paramintrt94/MOST-Vaccine-Exhibit/README.md

# MOST-Vaccine_Exhibit
Exhibit demonstrating how vaccines work
