paramintrt94/MOST-Vaccine-Exhibit/3D Models/Printed Parts (STL Files)/Exhibit Accessories/I2C Assembly Block.stl

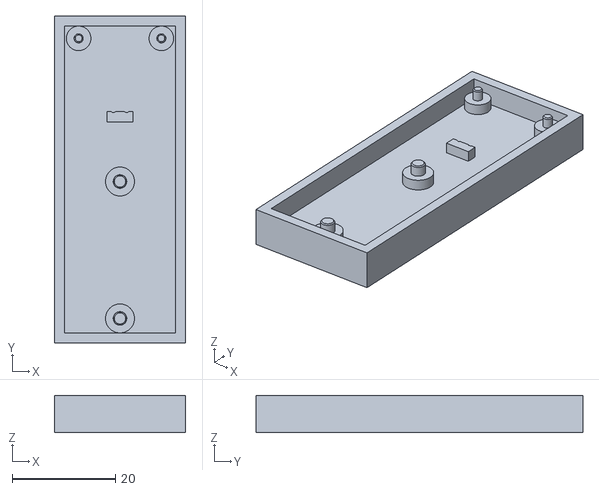
[picture p1: CAD file, 2021-02-23]
3D Models/Printed Parts (STL Files)/Exhibit Accessories/I2C Assembly Block.stl
25.4 x 63.3 x 7.25
