paramintrt94/MOST-Vaccine-Exhibit/3D Models/Printed Parts (STL Files)/Exhibit Accessories/Piece Locator.stl

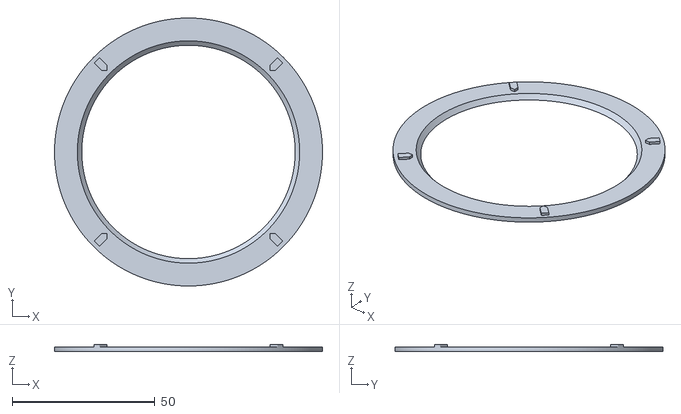
[picture p2: CAD file, 2021-02-23]
3D Models/Printed Parts (STL Files)/Exhibit Accessories/Piece Locator.stl
93.8 x 93.8 x 2.60
