paramintrt94/MOST-Vaccine-Exhibit/3D Models/Printed Parts (STL Files)/Model Pieces/Clear White Blood Cell.stl

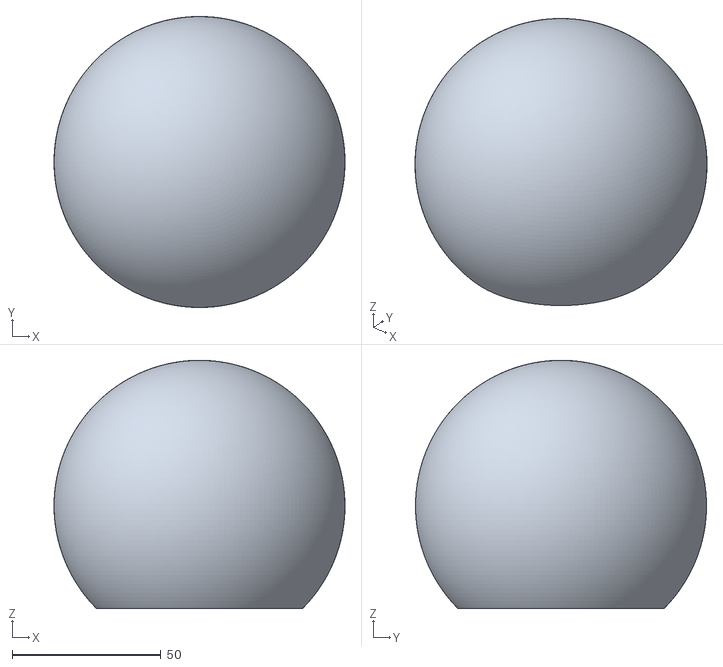
[picture p3: CAD file, 2021-02-23]
3D Models/Printed Parts (STL Files)/Model Pieces/Clear White Blood Cell.stl
98.0 x 98.0 x 83.6
