paramintrt94/MOST-Vaccine-Exhibit/3D Models/CAD Files/tca9548a_multiplexer.stp

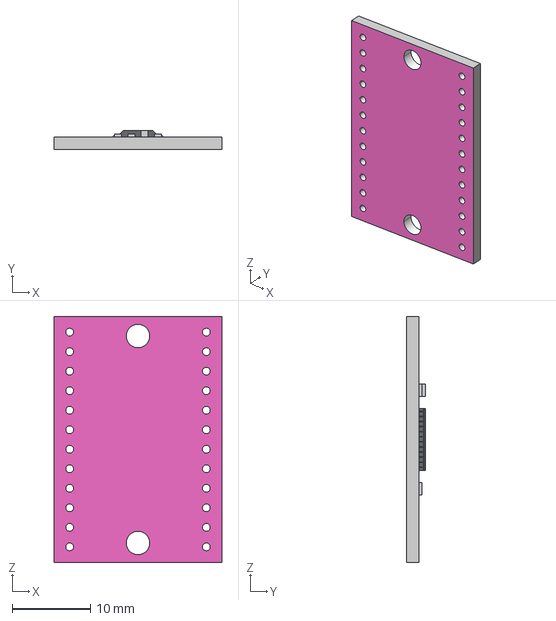
[picture p4: CAD file, 2021-02-23]
3D Models/CAD Files/tca9548a_multiplexer.stp
21.5 x 2.40 x 31.5 mm
