paramintrt94/MOST-Vaccine-Exhibit/3D Models/Printed Parts (STL Files)/Model Pieces/Red Active Virus Base.stl

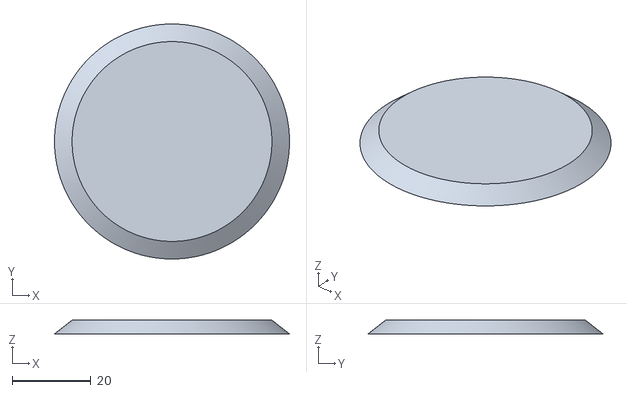
[picture p5: CAD file, 2021-02-23]
3D Models/Printed Parts (STL Files)/Model Pieces/Red Active Virus Base.stl
59.8 x 59.8 x 3.50
