paramintrt94/MOST-Vaccine-Exhibit/3D Models/Printed Parts (STL Files)/Exhibit Accessories/RGB Sensor Holder.stl

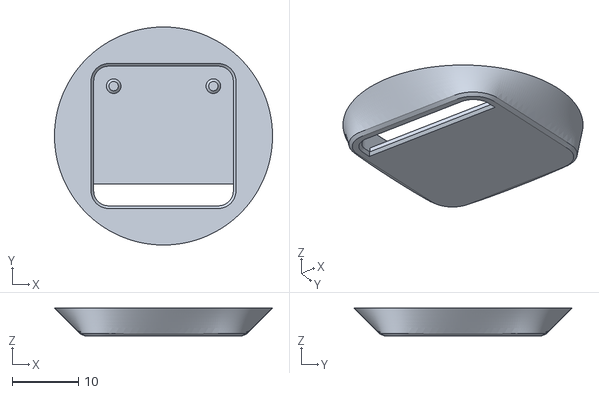
[picture p6: CAD file, 2021-02-23]
3D Models/Printed Parts (STL Files)/Exhibit Accessories/RGB Sensor Holder.stl
32.8 x 32.8 x 4.20
