paramintrt94/MOST-Vaccine-Exhibit/3D Models/Printed Parts (STL Files)/Model Pieces/Green Active Virus.stl

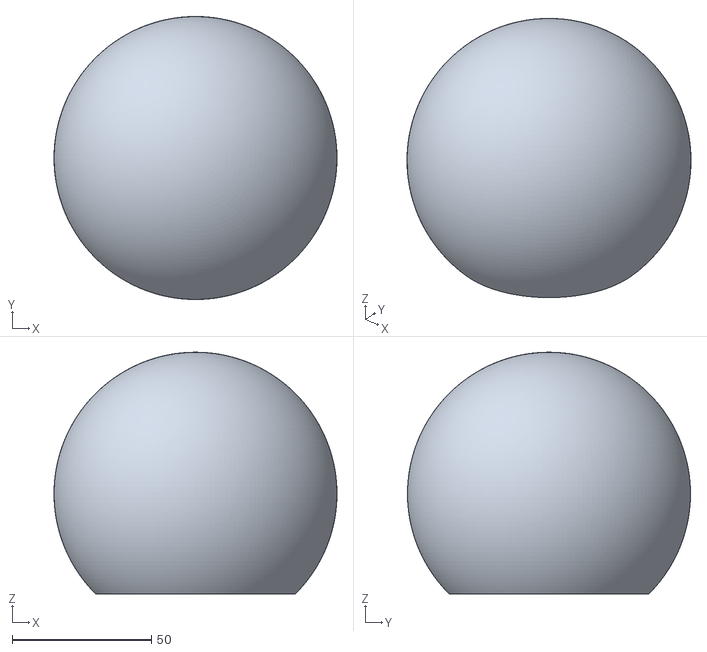
[picture p7: CAD file, 2021-02-11]
3D Models/Printed Parts (STL Files)/Model Pieces/Green Active Virus.stl
101.6 x 101.6 x 86.7
