paramintrt94/MOST-Vaccine-Exhibit/3D Models/Printed Parts (STL Files)/Exhibit Accessories/LED Diode Holder.stl

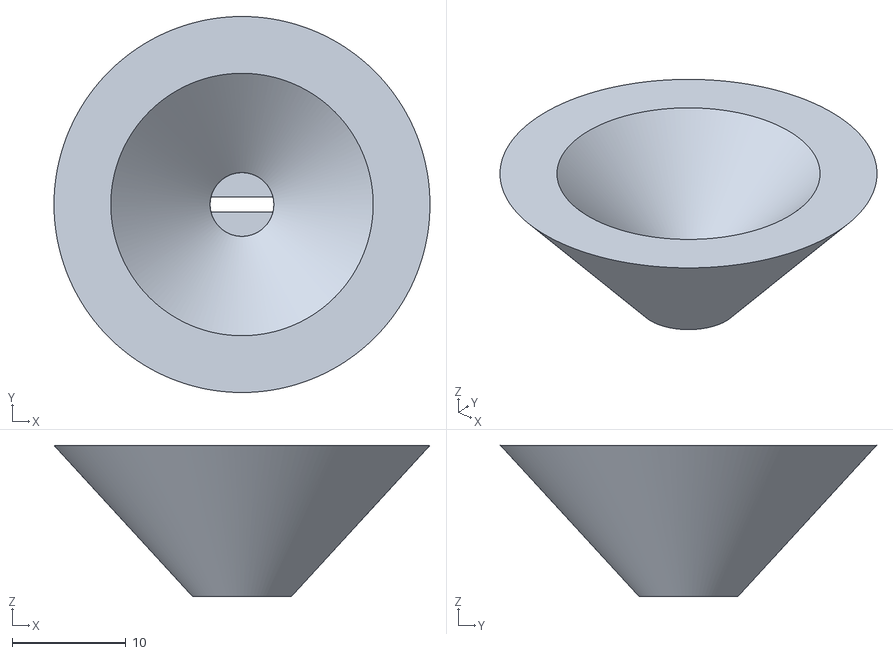
[picture p8: CAD file, 2021-02-23]
3D Models/Printed Parts (STL Files)/Exhibit Accessories/LED Diode Holder.stl
33.1 x 33.1 x 13.3
