paramintrt94/MOST-Vaccine-Exhibit/3D Models/Printed Parts (STL Files)/Exhibit Accessories/RGB Resistor Board Holder.stl

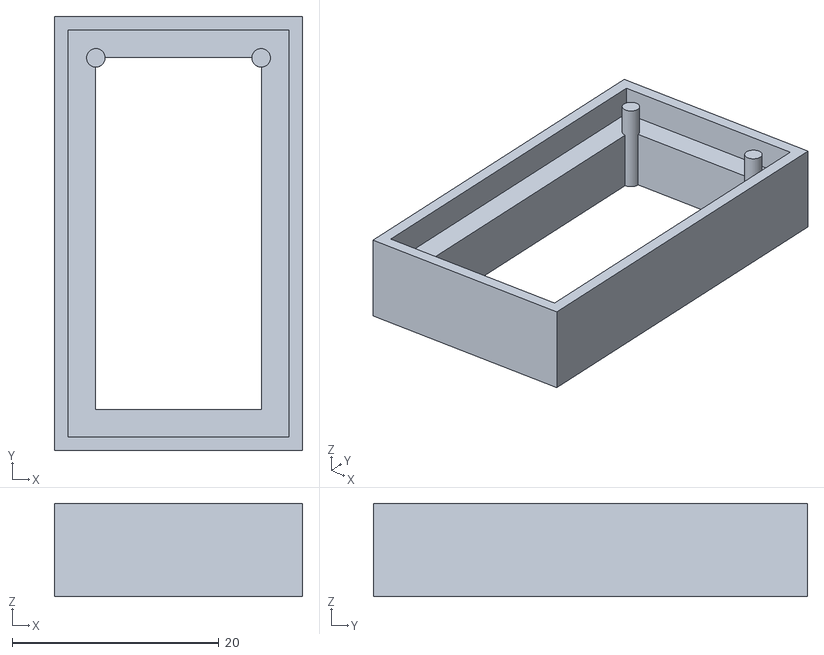
[picture p9: CAD file, 2021-02-23]
3D Models/Printed Parts (STL Files)/Exhibit Accessories/RGB Resistor Board Holder.stl
24.0 x 42.0 x 9.00
