paramintrt94/MOST-Vaccine-Exhibit/3D Models/Printed Parts (STL Files)/Model Pieces/Green Protein Receptor Cone.stl

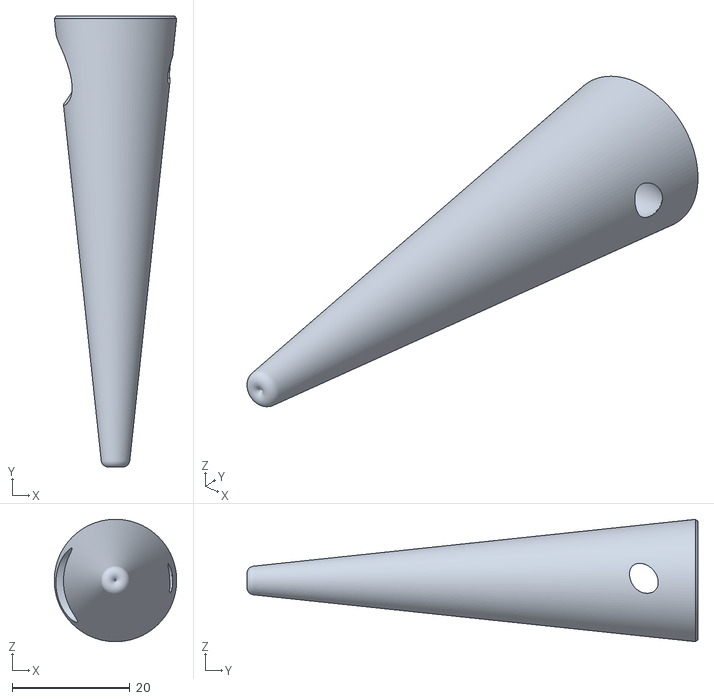
[picture p10: CAD file, 2021-02-10]
3D Models/Printed Parts (STL Files)/Model Pieces/Green Protein Receptor Cone.stl
20.8 x 76.5 x 20.8
