paramintrt94/MOST-Vaccine-Exhibit/3D Models/CAD Files/tcs34725_rgb_sensor.igs

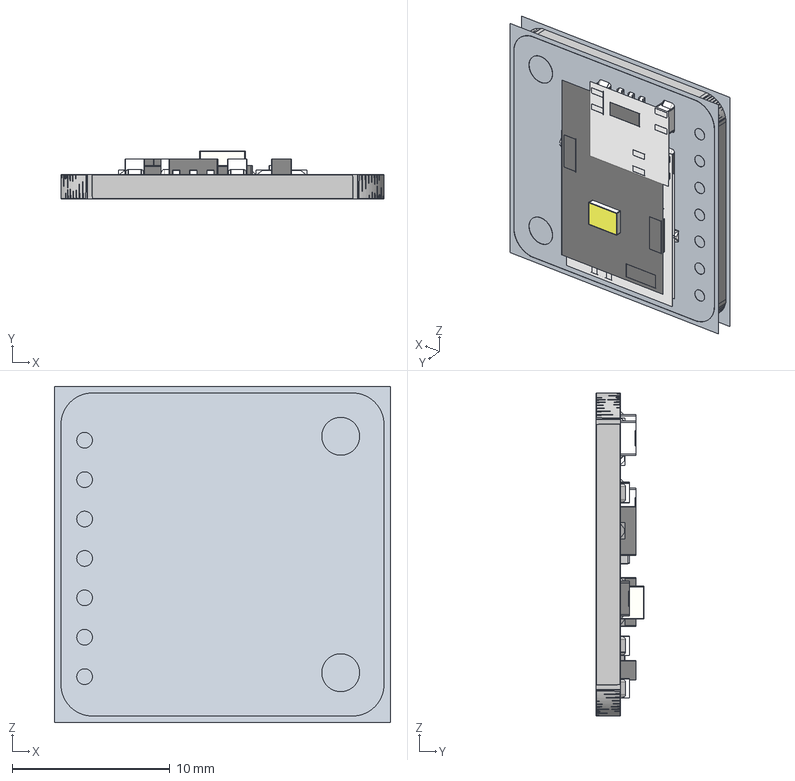
[picture p11: CAD file, 2021-02-23]
3D Models/CAD Files/tcs34725_rgb_sensor.igs
21.3 x 3.06 x 21.3 mm
