paramintrt94/MOST-Vaccine-Exhibit/(list of files, cad)

Other CAD files:
3D Models/Printed Parts (STL Files)/Model Pieces/Green Modified Virus.stl
