paramintrt94/MOST-Vaccine-Exhibit/(list of files, drawings)

Other design files:
Documentation/Vaccine Demo Schematic.fzz
