paramintrt94/MOST-Vaccine-Exhibit/(commit log)

2021-02-10 Reorganized file structure
    [Clear White Blood Cell 5mm Shell.stl, Clear White Blood Cell 6mm Shell.stl, Green Active Virus.stl, Green Modified Virus.stl, Green Protein Receptor Cone.stl, Red Active Virus Base.stl]
2021-02-10 Modified Clear WBC Shell + Top Bridge
    [Clear White Blood Cell 5mm Shell.stl]
2021-02-10 Fixed top overhang
    [Clear White Blood Cell 5mm Shell.stl]
2021-02-11 Updated green virus model with better base draft angle
    [Green Active Virus.stl, Red Active Virus Base.stl]
2021-02-12 Updated raspberry pi code to include gpiozero
2021-02-13 Various changes
    [Clear White Blood Cell 5mm Shell NO SUPPORT.stl, Clear White Blood Cell 6mm Shell.stl]
2021-02-17 Updated models and included wiring schematic documentation
    [Clear White Blood Cell.3mf, Clear White Blood Cell.stl, Vaccine Demo Schematic.fzz]
2021-02-18 Updated code to include immunization logic and timed reset
    [cell.py]
2021-02-20 Added multiplexer function and partly calibrated color codes
2021-02-23 Fixed ambient light hysterisis
    [cell.py, test.py]
2021-02-23 Updated exhbit model files and dependencies
    [Clear White Blood Cell 5mm Shell NO SUPPORT.stl, Clear White Blood Cell 5mm Shell.stl, Clear White Blood Cell.3mf, Clear White Blood Cell.stl, Green Active Virus.stl, Green Modified Virus.stl, Green Protein Receptor Cone.stl, I2C Assembly Block.stl]
2021-02-23 Updated schematic with new I2C ports on multiplexer
    [Vaccine Demo Schematic.fzz]
2021-02-23 Added button on off function
2021-02-24 Fixed ambient light hysterisis and implemented innoculation duration
    [cell.py]
